Kaushikfunde/PWM-Signal-Generator/hardware/fabrication/MinorProject-B_Cu.pdf

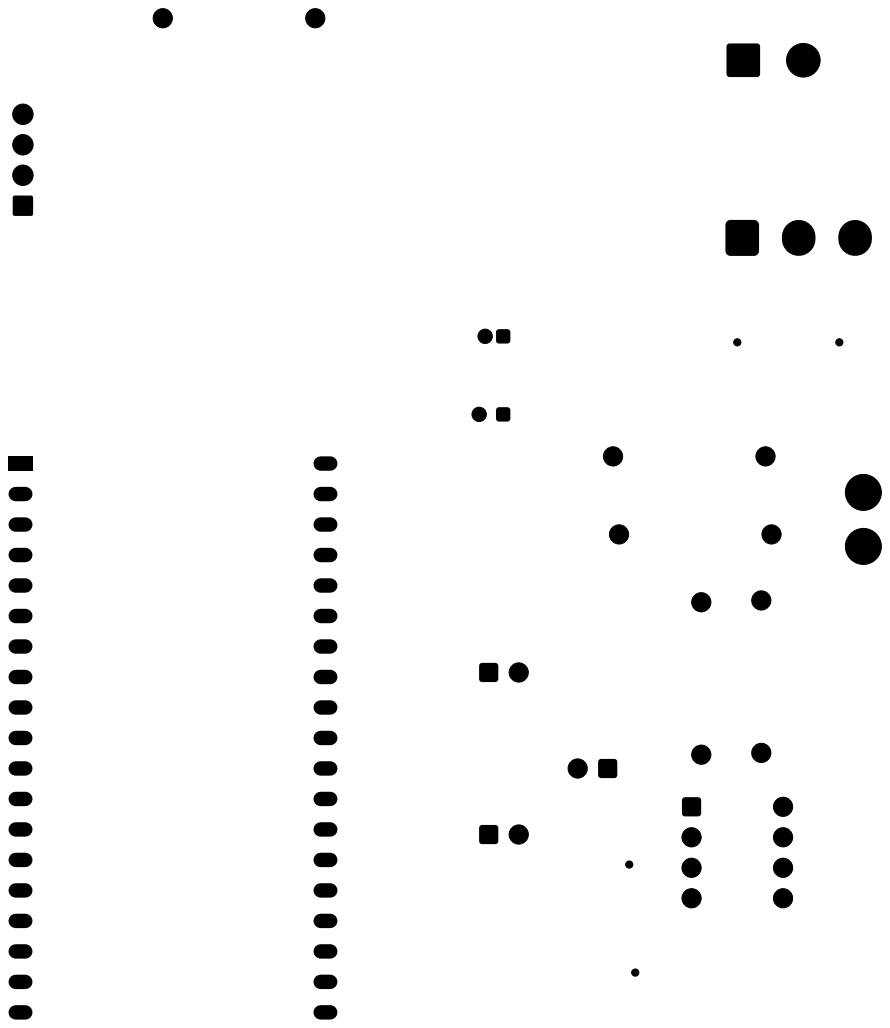
[picture p7: page 1]
