Kaushikfunde/PWM-Signal-Generator/hardware/fabrication/MinorProject-B_Mask.pdf

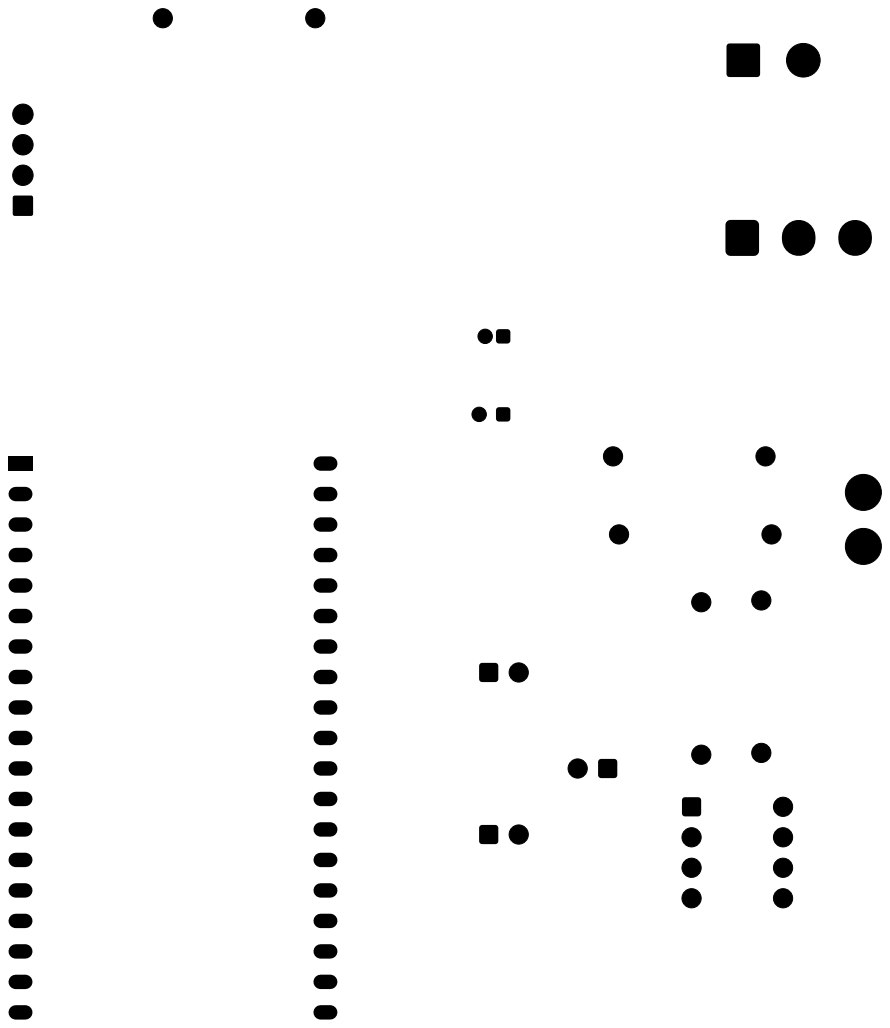
[picture p8: page 1]
