Kaushikfunde/PWM-Signal-Generator/hardware/fabrication/MinorProject-F_Cu.pdf

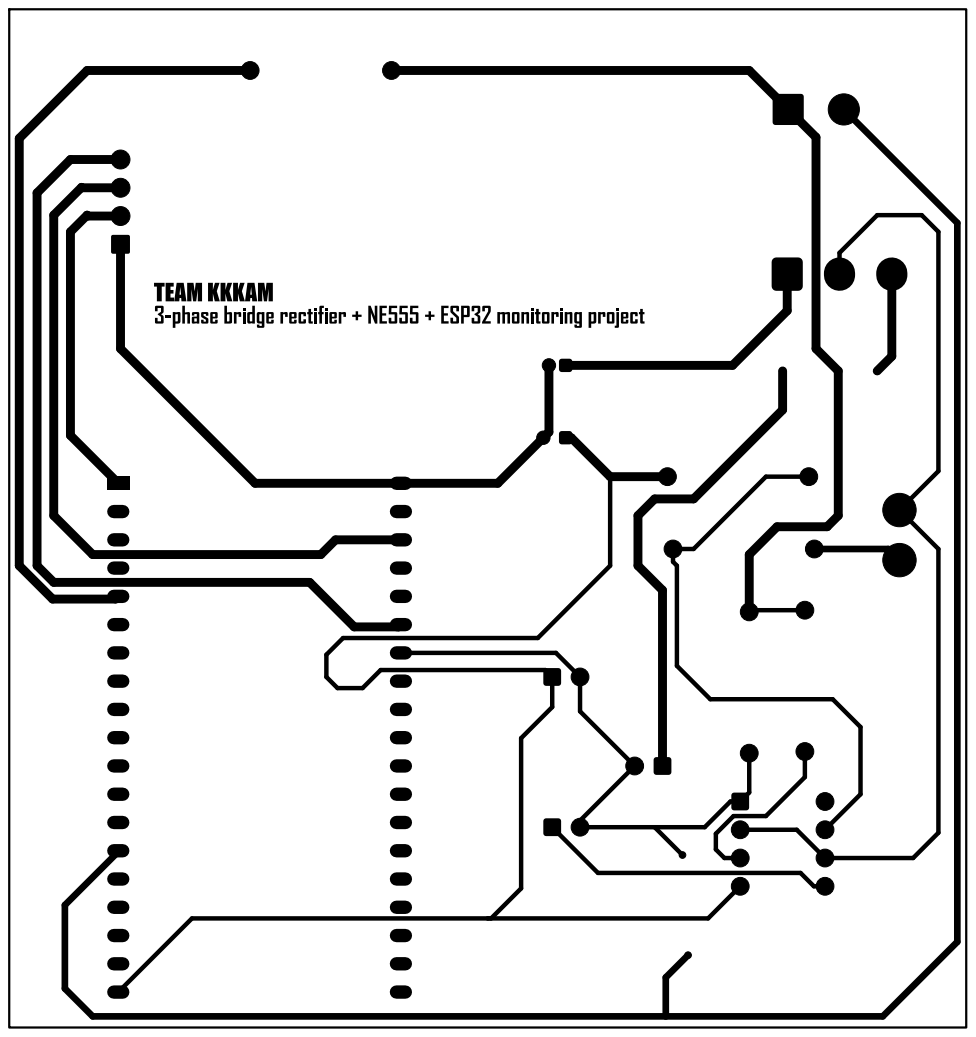
[picture p9: page 1]
