Kaushikfunde/PWM-Signal-Generator/hardware/fabrication/MinorProject-F_Silkscreen.pdf

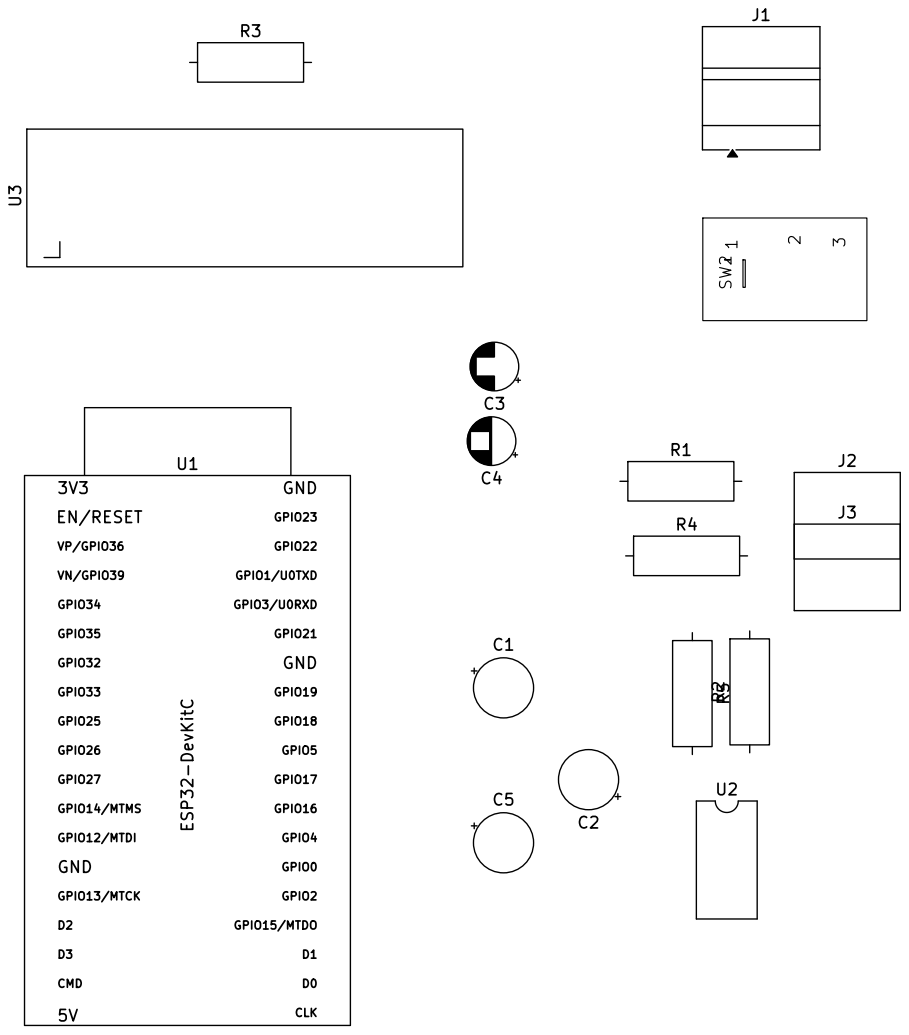
[picture p10: page 1]
