Kaushikfunde/PWM-Signal-Generator/hardware/MinorProject.kicad_pcb

## KiCad design hardware/MinorProject.kicad_pcb (2026-11-05)

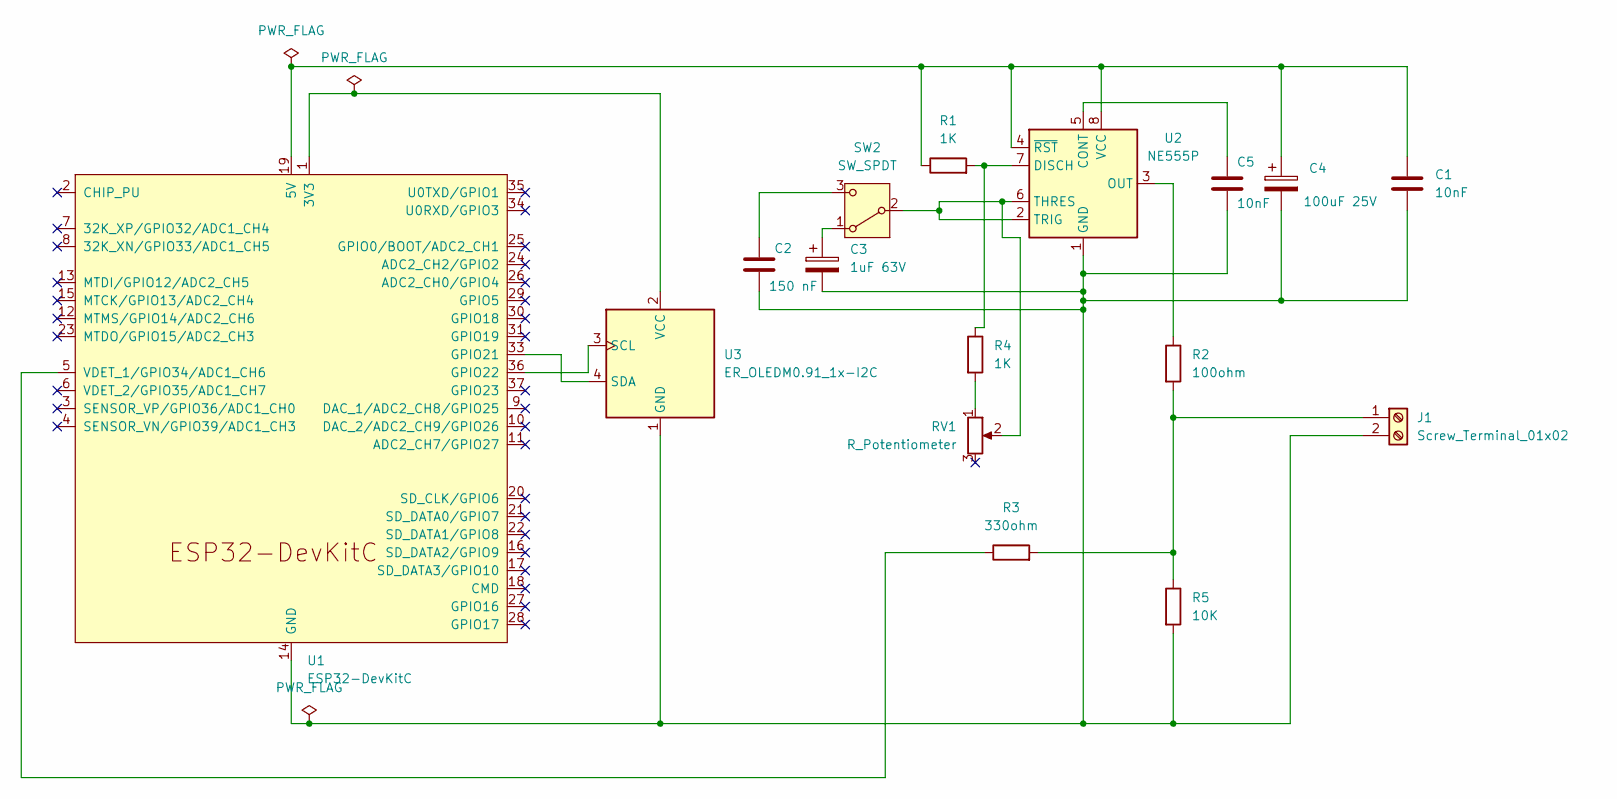
[picture p11: schematic MinorProject.kicad_sch]

Parts:
C1, C5: 10nF; CP_Radial_Tantal_D5.0mm_P2.50mm
C2: 150 nF; CP_Radial_Tantal_D5.0mm_P2.50mm
C3: 1uF 63V; CP_Radial_D4.0mm_P1.50mm
C4: 100uF 25V; CP_Radial_D4.0mm_P2.00mm
J1: Screw_Terminal_01x02; TerminalBlock_MetzConnect_Type011_RT05502HBLC_1x02_P5.00mm_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
R1, R4: 1K; R_Axial_DIN0309_L9.0mm_D3.2mm_P12.70mm_Horizontal
R2: 100ohm; R_Axial_DIN0309_L9.0mm_D3.2mm_P12.70mm_Horizontal
R3: 330ohm; R_Axial_DIN0309_L9.0mm_D3.2mm_P12.70mm_Horizontal
R5: 10K; R_Axial_DIN0309_L9.0mm_D3.2mm_P12.70mm_Horizontal
RV1: R_Potentiometer; Potentiometer_Vishay_T93YA_Vertical
SW2: SW_SPDT; Untitled
U1: ESP32-DevKitC
U2: NE555P; DIP-8_W7.62mm
U3: ER_OLEDM0.91_1x-I2C

Connections:
unnamed: J1.1, R2.2, R3.2, R5.1
unnamed: C1.2, C2.2, C3.2, C4.2, C5.2, J1.2, R5.2, U1.14 (GND), U1.32 (GND), U1.38 (GND), U2.1 (GND), U3.1 (GND)
unnamed 2: RV1.2, SW2.2 (B), U2.2 (TRIG), U2.6 (THRES); also elsewhere on the board
unnamed 3: R4.2, RV1.1; also elsewhere on the board
unnamed: C3.1, SW2.1 (A)
unnamed: C2.1, SW2.3 (C)
unnamed: U1.1 (3V3), U3.2 (VCC)
unnamed: C1.1, C4.1, R1.1, U1.19 (5V), U2.4 (~RST), U2.8 (VCC)
unnamed: U1.33 (GPIO21), U3.4 (SDA)
unnamed: U1.36 (GPIO22), U3.3 (SCL)
unnamed: R3.1, U1.5 (VDET_1/GPIO34/ADC1_CH6)
unnamed: C5.1, U2.5 (CONT)
unnamed: R1.2, R4.1, U2.7 (DISCH)
unnamed: R2.1, U2.3 (OUT)

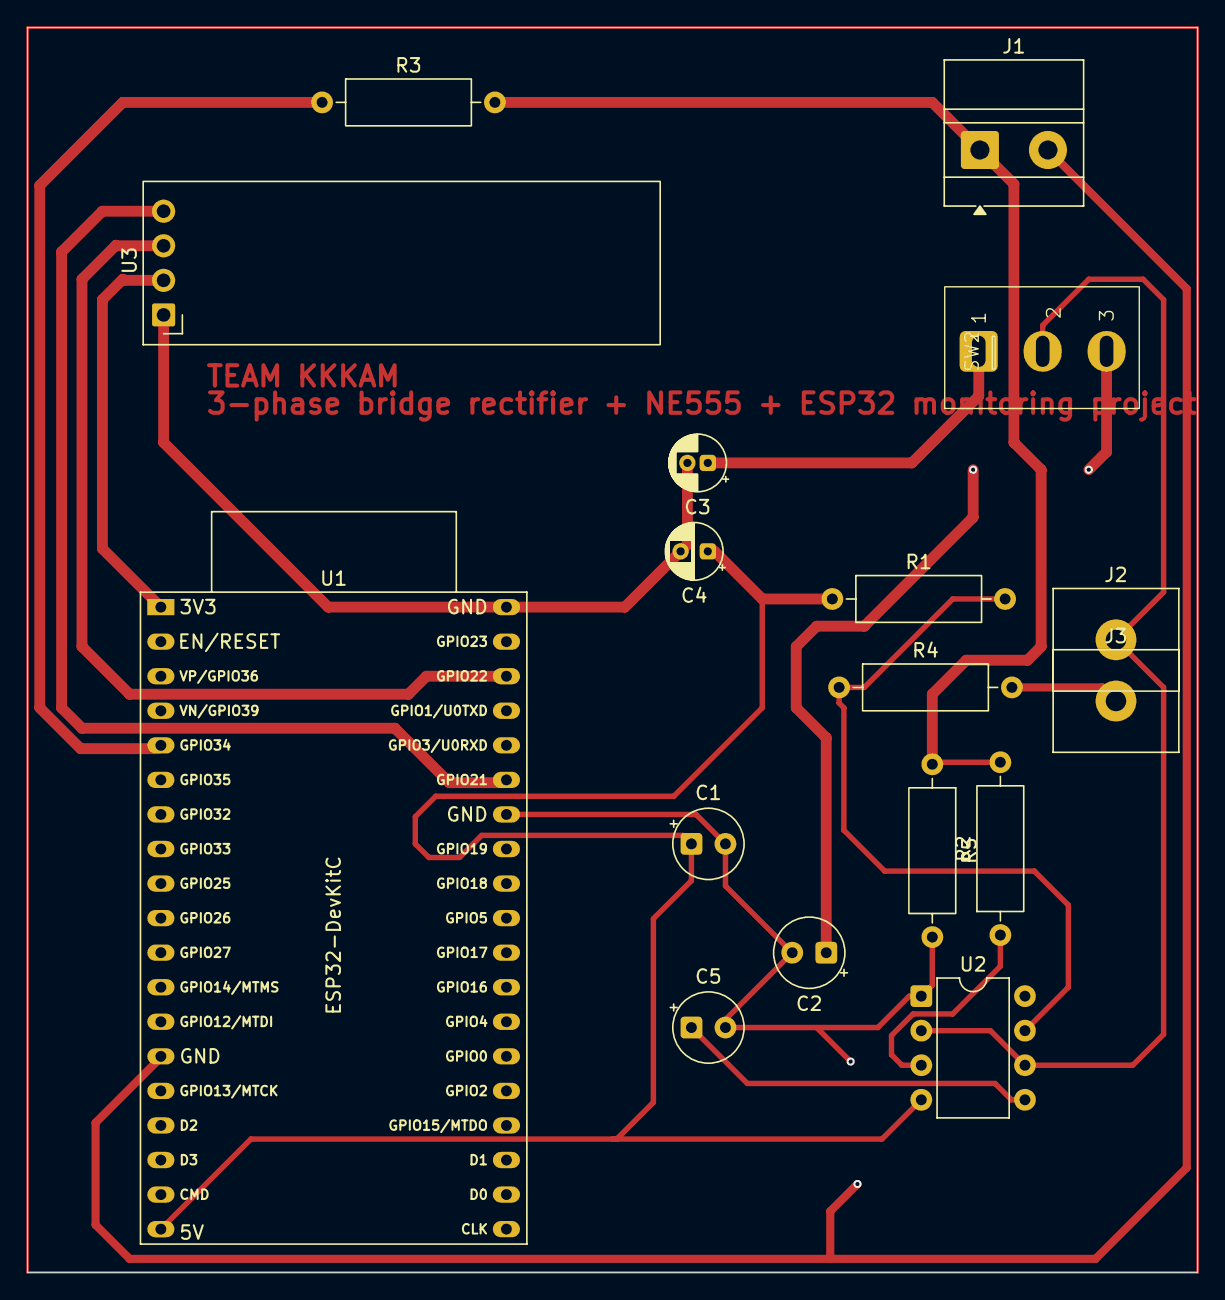
[picture p12: board MinorProject.kicad_pcb from above]

Board: 2 copper layers, 86.0 x 91.5 mm, 17 parts (0 on the bottom side), 14 nets.

Other parts of the board:
J2, J3: Screw_Terminal_01x01; TerminalBlock_MetzConnect_360271_1x01_Horizontal_ScrewM3.0_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

Their connections:
unnamed 2: J2.1 (Pin_1_1); also elsewhere on the board
unnamed 3: J3.1 (Pin_1_1); also elsewhere on the board
