Kaushikfunde/PWM-Signal-Generator/(commit log)

2026-11-05 Initial commit: NE555 PWM generator and ESP32 analyzer
    [MinorProject.kicad_pcb, MinorProject.kicad_sch]
2026-11-06 Link portfolio case study and author profile
    Connect the project README to the live case study and portfolio site.
